Mgns55/chapter-ger/README.md

# Chapter Player for Audiobookshelf

> **Deutsche Fassung** von [chrismtopher/chapter](https://github.com/chrismtopher/chapter) mit deutscher Oberfläche, abschaltbarem Bluetooth und Leistungsverbesserungen für den Raspberry Pi Zero. Installation:
>
> ```bash
> curl -fsSL https://raw.githubusercontent.com/Mgns55/chapter-ger/v0.3.31/scripts/install-raspberry-pi.sh | bash
> ```
>
> **Zusätzlich in dieser Fassung**
>
> - **Serien** erscheinen im Menü als ein Eintrag; erst nach Auswahl kommen die einzelnen Folgen (in Reihenfolge). Abschaltbar unter *Einstellungen → Serien zusammenfassen*.
> - **Offline-Speicher**: gehörte Bücher liegen danach auf der SD-Karte, starten sofort und laufen auch ohne WLAN.
> - **Profile** (z. B. ein Audiobookshelf-Benutzer pro Kind): unter *Einrichtung* mit Profilname anmelden; am Player Menü-Knopf 3 Sekunden halten zum Wechseln (wenn Bluetooth aus ist).
> - **Akku** (PiSugar 3 / 3 Plus, wird automatisch erkannt): Ladestand im Display, Ansage bei 15 %, sauberes Herunterfahren bei 5 %.
> - **3,12″-Display** (SSD1322, z. B. UN312-5664-7): unter *Einstellungen → Display* wählen; lange Titel stehen dort zweizeilig. Steht das Bild auf dem Kopf: „3,12 Zoll gedreht“.
> - **Kein Knacken**: Verstärker im Leerlauf abschalten – dazu den SD-Pin des MAX98357A mit GPIO 17 (Pin 11) verbinden und unter *Einstellungen* einschalten.
> - **Home Assistant** per MQTT (automatische Erkennung): Status, Titel, Kapitel, Akku, Hörzeit, Lautstärke, Abspielen/Pause, Profilwahl.
> - **Kopfhörer** (optional, Buchse an der Klinke des Pi): unter *Einstellungen → Kopfhörerbuchse* einschalten; Umschalten über das Schnellmenü (Menü-Knopf 3 Sekunden halten), die Setup-Seite oder Home Assistant. Eigene Höchstlautstärke für Kopfhörer.
> - **Einschlaf-Timer am Gerät**: im Abspiel-Bildschirm auf *Nacht* → 15 Min, 30 Min oder Kapitelende; die Restzeit steht dann auf dem Knopf.
> - **Sortierung nach Datum hinzugefügt** (neueste zuerst) und **abgeschlossene Hörbücher ausblenden** unter *Einstellungen*.
> - **Hörzeit-Übersicht** für Eltern auf der Übersichtsseite: heute, letzte 7 Tage, meistgehörte Bücher, Hören nach 20 Uhr.



A simple Raspberry Pi friendly Chapter player for Audiobookshelf.

Current release: **[v0.3.12](https://github.com/chrismtopher/chapter/releases/tag/v0.3.12)**

Chapter Player for Audiobookshelf is an independent third-party project and is not affiliated with or supported by the Audiobookshelf project.

Chapter is a native Linux appliance app built with Python and GStreamer. It signs in to Audiobookshelf with a dedicated user account, securely stores the server-issued tokens, shows a simple two-line OLED library and playback interface, resumes from Audiobookshelf progress, and syncs progress back while listening.

The target device is a small enclosure with a 2.08 inch SH1122 SPI OLED, two KY-040 rotary encoders, a MAX98357A I2S amp, and an internal speaker.

## Quick Install

Flash Raspberry Pi OS Lite onto a Raspberry Pi Zero 2 W/WH, enable SSH, and connect to the Pi. The recommended setup username is `chapter` and hostname is `chapter-player`.

Then run:

```bash
curl -fsSL https://raw.githubusercontent.com/chrismtopher/chapter/v0.3.12/scripts/install-raspberry-pi.sh | bash
sudo reboot
```

The installer handles the software setup:

- system packages
- project clone/update in `/home/chapter/audiobookshelf-player`
- SPI enablement
- MAX98357A I2S audio and ALSA config
- setup web page service
- OLED service and boot splash
- port 80 setup-page proxy
- captive portal DNS helper
- Bluetooth unblock helper
- BlueALSA Bluetooth audio backend

For the complete hardware, flashing, wiring, setup, and troubleshooting walkthrough, see the [Raspberry Pi Zero 2 W install guide](docs/raspberry-pi-zero-2w-install.md).

## Hardware

Recommended build:

- Raspberry Pi Zero 2 WH, or Raspberry Pi Zero 2 W with a soldered 40-pin header
- 16 GB or larger microSD card
- Regulated 5 V power supply rated for at least 2 A; see the install guide for the Adafruit 5993's 1.5 A power-path limitation
- 2.08 inch 256x64 SH1122 SPI OLED
- Two KY-040 rotary encoder modules
- MAX98357A I2S mono amplifier breakout
- 4 ohm speaker
- 1.5 A inline fuse on the USB-C 5 V positive lead
- 3 mm warm-white power indicator LED for the lower-right front-cover hole
- Cross-connect wires for component wiring

The wiring tables are in the [install guide](docs/raspberry-pi-zero-2w-install.md#wire-the-hardware).

Purchase links for the recommended parts are in [docs/hardware-links.md](docs/hardware-links.md).

Printable case files are in [hardware/case](hardware/case).

## Setup

After installation and reboot, open the setup page from a phone or computer on the same network:

```text
http://chapter-player.local
```

If the player is not connected to Wi-Fi, it starts an open setup hotspot:

```text
Network:  Chapter-Setup
Password: none
Page:     http://10.42.0.1
```

The setup page lets you enter your Wi-Fi details and log the player into Audiobookshelf. Create a dedicated Audiobookshelf user for the player and restrict that user to the appropriate library or tags.

For a simple handout, see the [first boot one-sheet](docs/first-boot-one-sheet.md).

For a package-style quick start card, open the [PDF](docs/first-boot-quick-start.pdf) or [JPG](docs/first-boot-quick-start.jpg).

## Controls

- Turn the Select knob to browse books.
- Click the Select knob to choose.
- Turn the Volume knob to change volume.
- Click the Volume knob to mute or unmute.
- Hold the Volume knob for 10 seconds to show the setup address.
- Hold the Select knob for 3 seconds to open the Bluetooth menu.
- In the Bluetooth menu, turn the Select knob to choose `Enable`, `Disable`, `Pair`, `Unpair`, or `Back`, then click to select.
- To pair a speaker or headphones, put the device in pairing mode, choose `Pair`, wait for the device list, turn to the device name, and click to connect.
- Parents can enable `Spoken navigation` on the Settings tab to have the player read highlighted book titles and controls aloud. It is disabled by default.
- With spoken navigation enabled, Volume-knob changes are announced at 10% intervals, volume stops at 10%, and pressing the Volume knob does not mute the player.

## Features

- Two-line SH1122 OLED library and playback UI
- Select and Volume rotary controls
- Internal speaker playback through GStreamer
- Audiobookshelf login through the local setup page
- Admin web page player controls, including play/pause and volume
- Configurable `1x`, `1.5x`, and `2x` playback speed
- Configurable library ordering by title or author last name
- Optional offline spoken navigation for book titles and controls using a tuned eSpeak NG voice
- System-tab software update checks and one-button stable release installation
- Resume from Audiobookshelf progress
- Periodic progress sync back to Audiobookshelf
- Multi-file audiobook playback
- Continue/start-over prompt when a book has listening history
- Wi-Fi setup fallback hotspot

## Security

The administration page is intentionally passwordless and is intended only for a trusted private home network. Anyone who can reach it can control or reset the player. Do not expose the player to the internet, configure router port forwarding, or connect it to an untrusted network.

CSRF protection prevents unrelated websites from submitting commands through your browser, but it does not authenticate people already connected to the same network. Use a dedicated, restricted Audiobookshelf account for the player. See the full [security policy](SECURITY.md) for details and vulnerability-reporting instructions.

## Development

Run the test suite with:

```bash
python3 -m unittest discover -s tests
```

Run the isolated Raspberry Pi OS Lite installer simulation with:

```bash
tests/mock_raspberry_pi_install.sh
```

See [docs/appliance-design.md](docs/appliance-design.md) for hardware notes, UI behavior, and future direction.

Release history is recorded in [CHANGELOG.md](CHANGELOG.md).

## License

This project is open source under the terms of the [MIT License](LICENSE).
