Mgns55/chapter-ger/hardware/case/pro/stl/chapter-pro-lautsprecher-adapter.stl

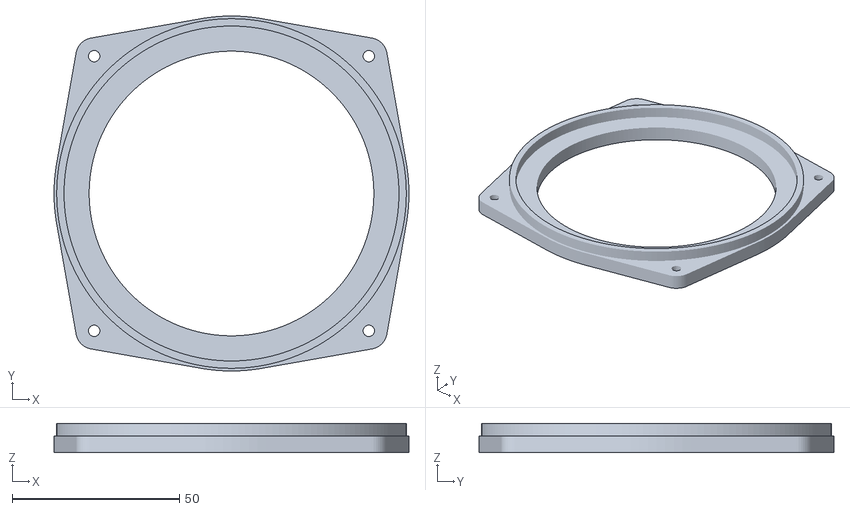
[picture p4: CAD file, 2026-11-08]
hardware/case/pro/stl/chapter-pro-lautsprecher-adapter.stl
106.0 x 106.0 x 8.79
