Mgns55/chapter-ger/hardware/case/stl/chapter-case-back-v5-zero-de.stl

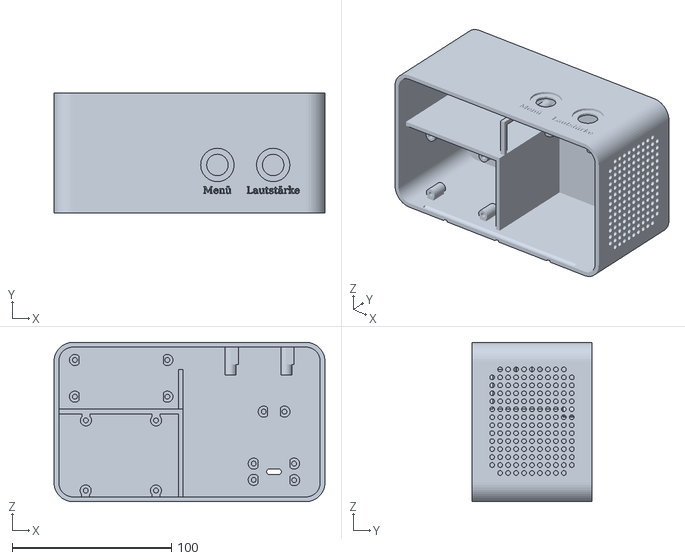
[picture p5: CAD file, 2026-10-25]
hardware/case/stl/chapter-case-back-v5-zero-de.stl
170.0 x 75.0 x 100.0
