Mgns55/chapter-ger/hardware/case/pro/stl/chapter-pro-rueckwand.stl

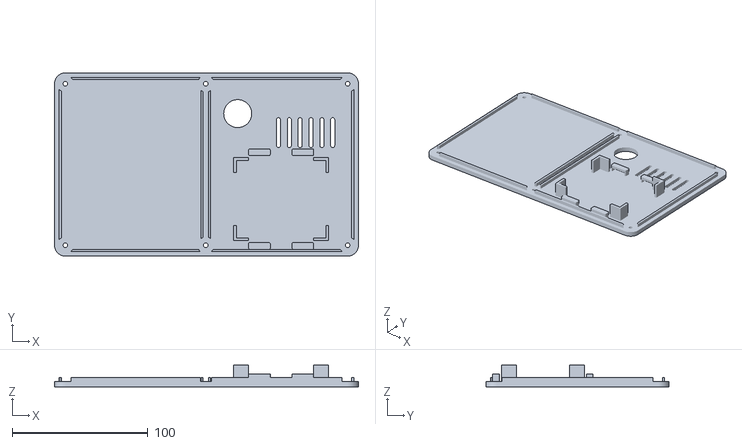
[picture p6: CAD file, 2026-11-01]
hardware/case/pro/stl/chapter-pro-rueckwand.stl
224.0 x 135.0 x 16.0
