Mgns55/chapter-ger/hardware/case/pro/stl/usb-loch-probe.stl

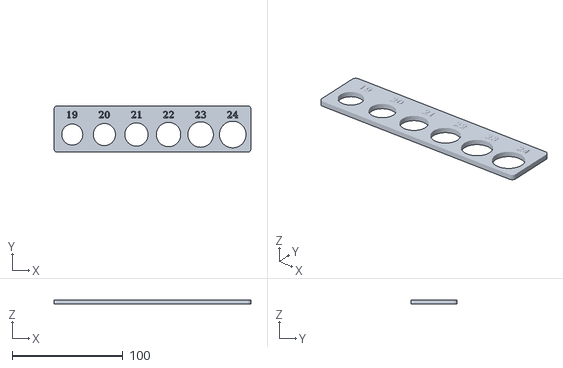
[picture p7: CAD file, 2026-11-01]
hardware/case/pro/stl/usb-loch-probe.stl
178.0 x 42.0 x 4.00
