Mgns55/chapter-ger/hardware/case/pro/stl/chapter-pro-gehaeuse.stl

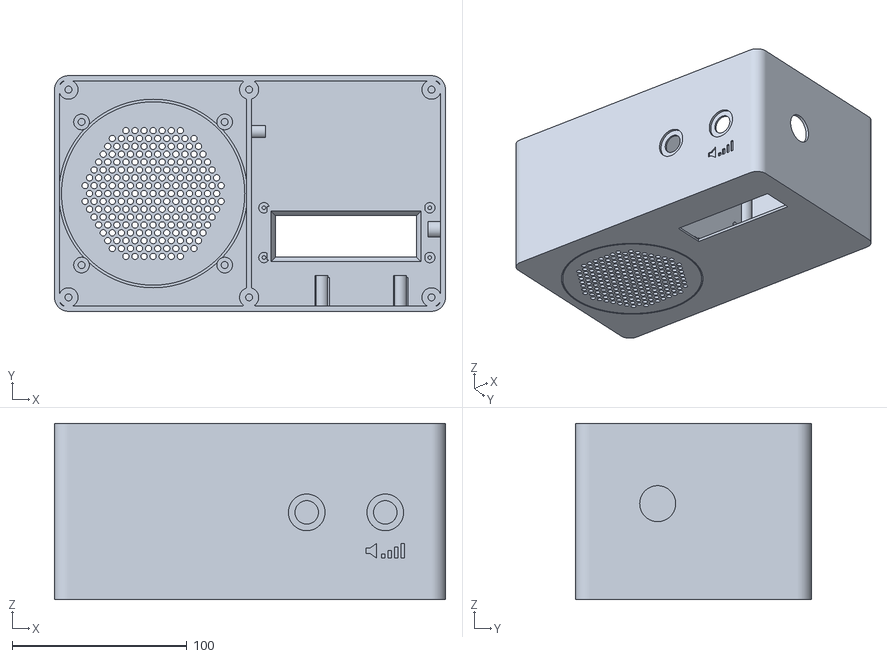
[picture p8: CAD file, 2026-10-29]
hardware/case/pro/stl/chapter-pro-gehaeuse.stl
224.0 x 135.0 x 101.0
