Mgns55/chapter-ger/hardware/case/pro/stl/chapter-pro-kopfhoererhalter.stl

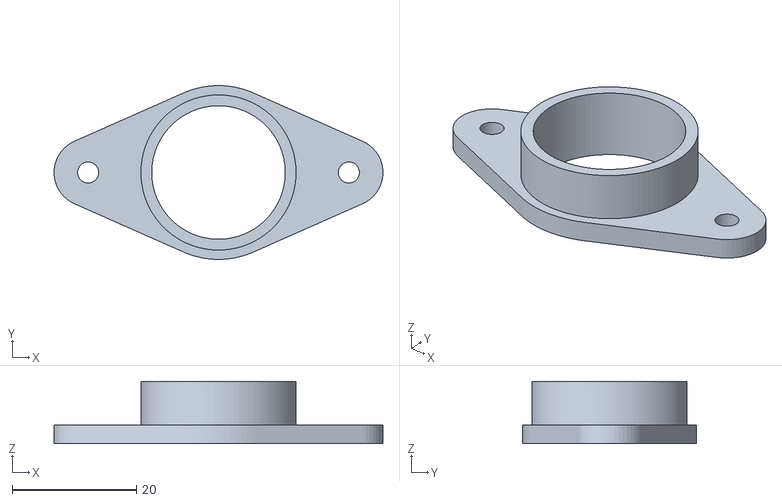
[picture p9: CAD file, 2026-10-27]
hardware/case/pro/stl/chapter-pro-kopfhoererhalter.stl
53.0 x 28.0 x 10.0
