Mgns55/chapter-ger/hardware/case/pro/stl/chapter-pro-lautsprecherring.stl

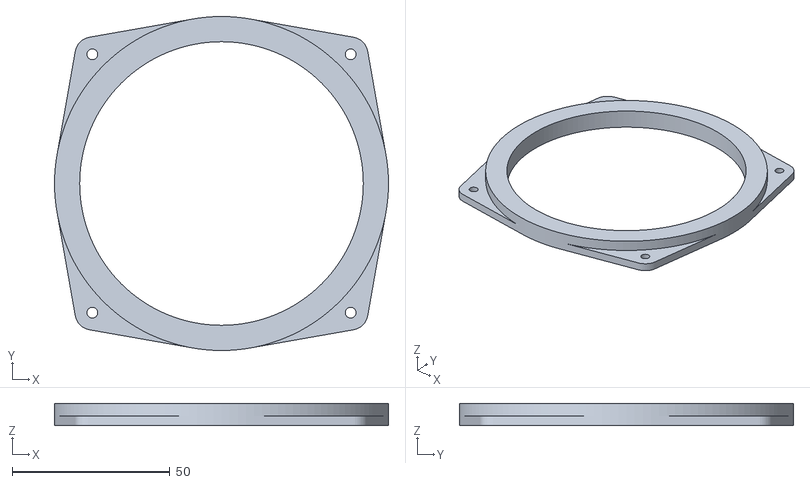
[picture p10: CAD file, 2026-10-25]
hardware/case/pro/stl/chapter-pro-lautsprecherring.stl
106.0 x 106.0 x 7.00
