Mgns55/chapter-ger/(list of files, cad)

Other CAD files:
hardware/case/stl/chapter-case-back-v5-pi3a.stl
