Mgns55/chapter-ger/docs/raspberry-pi-zero-2w-install.md

# Raspberry Pi Zero 2 W Install Guide

This guide walks through building a fresh Chapter Player for Audiobookshelf on a Raspberry Pi Zero 2 W or Zero 2 WH.

It assumes you already have an Audiobookshelf server running somewhere on your network or reachable by URL. The player stores an Audiobookshelf user token, so create a dedicated Audiobookshelf user for the player instead of using an admin account.

The software setup is handled by the installer. This guide covers the parts a new builder still needs: buying parts, flashing Raspberry Pi OS Lite, wiring the hardware, running the installer, opening the setup page, and troubleshooting.

## What To Buy

- Raspberry Pi Zero 2 WH, or a Raspberry Pi Zero 2 W plus a soldered 40-pin header.
- 16 GB or larger microSD card. Raspberry Pi OS Lite fits on less, but 16 GB or 32 GB gives you room for updates and logs.
- Good regulated 5 V power supply. Raspberry Pi recommends 2 A capacity for the Zero 2 W; 2.5 A provides additional source-side headroom for the OLED and speaker amp. See the USB-C power note below because the specified Adafruit 5993 breakout is the limiting component.
- 2.08 inch 256x64 SH1122 SPI OLED module.
- Two KY-040 rotary encoder modules.
- MAX98357A I2S mono amplifier breakout.
- 4 ohm speaker.
- 1.5 A inline fuse for the USB-C 5 V positive lead. The linked holder kit includes a suitable 1.5 A fast-blow 5x20 mm fuse.
- 3 mm warm-white power indicator LED for the lower-right front-cover hole. The build uses the 5-6 V [Dioramo 13240](https://dioramo.com/products/13240).
- Cross-connect wires or soldered wiring, plus an enclosure. The build uses [Amazon ASIN B01EV70C78](https://www.amazon.com/dp/B01EV70C78?th=1) for component wiring.

For links to the recommended parts, see the [hardware links](hardware-links.md).

The Pi Zero 2 W Wi-Fi radio is 2.4 GHz only. Use a 2.4 GHz network during setup.

## Flash Raspberry Pi OS

1. Install Raspberry Pi Imager on your computer.
2. Insert the microSD card.
3. In Imager, choose the Pi model and select **Raspberry Pi OS Lite**.
4. Open OS customisation before writing the card.
5. Set the hostname to `chapter-player`.
6. Set the username to `chapter`.
7. Set a password you will remember.
8. Configure your 2.4 GHz Wi-Fi network and country.
9. Enable SSH.
10. Write the card, insert it into the Pi, and power the Pi.

Wait a few minutes for the first boot. Then connect from your computer:

```bash
ssh chapter@chapter-player.local
```

If `.local` does not resolve on your network, find the Pi's IP address from your router and use:

```bash
ssh chapter@192.168.1.42
```

## Run The Installer

Run this on the Pi:

```bash
curl -fsSL https://raw.githubusercontent.com/chrismtopher/chapter/v0.3.12/scripts/install-raspberry-pi.sh | bash
```

The installer handles the software setup:

- installs required system packages
- creates or updates the `chapter` service user
- clones or updates the project in `/home/chapter/audiobookshelf-player`
- enables SPI for the OLED
- configures the MAX98357A I2S audio overlay
- installs the ALSA mixer config
- installs and enables the setup page service
- installs and enables the OLED service and boot splash
- installs the port 80 setup-page proxy
- installs the captive portal DNS helper
- installs the Bluetooth unblock helper
- installs and enables the BlueALSA Bluetooth audio backend

When it finishes, it will tell you to reboot. If you have not wired the hardware yet, shut the Pi down instead:

```bash
sudo shutdown -h now
```

If the hardware is already wired, reboot:

```bash
sudo reboot
```

To inspect the installer before running it:

```bash
curl -fsSLO https://raw.githubusercontent.com/chrismtopher/chapter/v0.3.12/scripts/install-raspberry-pi.sh
less install-raspberry-pi.sh
bash install-raspberry-pi.sh
```

## Wire The Hardware

Power the Pi off before wiring. Disconnect power, then wire the parts.

All `GPIO` numbers below use Raspberry Pi BCM numbering. The separate `Physical Pin` column identifies the numbered position on the 40-pin header. Do not confuse the two numbering systems.

### OLED

| OLED Pin | Raspberry Pi Signal | Physical Pin |
| --- | --- | ---: |
| `VCC` | 3.3 V | 1 |
| `GND` | GND | 6 |
| `SCL` / `CLK` | GPIO11 / SCLK | 23 |
| `SDA` / `DIN` | GPIO10 / MOSI | 19 |
| `CS` | GPIO8 / CE0 | 24 |
| `DC` | GPIO24 | 18 |
| `RES` / `RST` | GPIO25 | 22 |

### Select Knob (KY-040)

Power the KY-040 from 3.3 V, not 5 V.

| KY-040 Pin | Raspberry Pi Signal | Physical Pin |
| --- | --- | ---: |
| `+` | 3.3 V | 1 |
| `GND` | GND | 9 |
| `CLK` | GPIO5 | 29 |
| `DT` | GPIO6 | 31 |
| `SW` | GPIO13 | 33 |

### Volume Knob (KY-040)

| KY-040 Pin | Raspberry Pi Signal | Physical Pin |
| --- | --- | ---: |
| `+` | 3.3 V | 17 |
| `GND` | GND | 14 |
| `CLK` | GPIO12 | 32 |
| `DT` | GPIO16 | 36 |
| `SW` | GPIO26 | 37 |

### MAX98357A I2S Amp

| Amp Pin | Raspberry Pi Signal | Physical Pin |
| --- | --- | ---: |
| `VIN` | 5 V | 2 or 4 |
| `GND` | GND | 20, 25, 30, 34, or 39 |
| `BCLK` | GPIO18 | 12 |
| `LRC` / `LRCLK` | GPIO19 | 35 |
| `DIN` | GPIO21 | 40 |
| `SD` / `SD_MODE` | Leave disconnected | - |
| Speaker `+` / `-` | Speaker terminals | - |

The default software leaves `SD` / `SD_MODE` alone. That lets the breakout's own mode resistor choose the default mono mix.

The MAX98357A speaker output is differential. Connect the speaker only between the amplifier's `+` and `-` speaker terminals; do not connect either speaker terminal to Raspberry Pi ground. Keep the speaker pair short and, if practical, twisted together and routed away from the OLED and encoder wiring.

### USB-C Power Port And Fuse

If you are using the Adafruit 5993 vertical USB-C breakout as the rear power port, put a 1.5 A inline fuse on the positive 5 V leg coming from the USB-C board before it reaches the Raspberry Pi.

On the Adafruit 5993, solder the positive power lead to either pad labeled `VBUS` and the negative power lead to either pad labeled `GND`. The two breakout rows are duplicates, so either matching `VBUS`/`GND` pair may be used. `VBUS` is the raw 5 V supply from the USB-C connector; do not substitute a `CC`, `SBU`, `D+`, or `D-` pad for either power connection. Using red wire for `VBUS` and black wire for `GND` is recommended.

The build uses the holder and fuse assortment in [Amazon ASIN B0813Q4S6P](https://www.amazon.com/dp/B0813Q4S6P). Install the included **1.5 A fast-blow 5x20 mm fuse** in the holder; do not select one of the higher-current fuses from the assortment.

```text
Adafruit 5993 VBUS pad (+5 V) -> 1.5 A fuse -> Raspberry Pi 5 V pin 2 or 4
Adafruit 5993 GND pad  (-)    -> Raspberry Pi GND
```

Any 5 V branch for the amp should be taken from the fused 5 V side. Do not put the fuse in series with `GND`, `D+`, or `D-`.

Leave `D+`, `D-`, `CC`, and `SBU` unwired in the Chapter build. The Adafruit 5993 is used for 5 V power only.

Adafruit documents this breakout's USB-C current arrangement for 5 V at up to 1.5 A, while Raspberry Pi recommends a 2 A-capable supply for a Zero 2 W by itself. The tested Chapter build normally remains within the breakout's limit, but the 5993 is the power-path constraint. If the Pi reports undervoltage, reboots at high volume, or behaves unreliably, stop using it until you replace the input path with a regulated 5 V solution rated for at least 2 A.

Feeding the Pi through a 5 V header pin bypasses the Pi's normal power-input protection. Verify polarity and voltage before connecting it. Never power Chapter through the Adafruit breakout and the Pi's original `PWR IN` micro-USB port at the same time.

### Power Indicator LED

The small hole at the lower-right of the front cover, viewed from the outside, is for the power indicator. Insert the 3 mm LED into the hole from the back of the cover, then secure it with a small dab of hot glue. Keep glue away from the LED leads and wire joints.

Splice the LED into the USB-C power wiring as a parallel branch after the fuse. It must not be placed in series with either power lead; the Pi must still have a direct fused 5 V and ground connection.

The [Dioramo 13240](https://dioramo.com/products/13240) is rated for 5-6 V and has its current-limiting resistor already wired in. Its white-marked wire is the positive anode and its black wire is the negative cathode, so no additional resistor is required on Chapter's 5 V rail.

```text
Fused USB-C 5 V ----+------------------------> Raspberry Pi 5 V / amp 5 V
                    |
                    +-----------------------> Dioramo 13240 white-marked wire (+)

USB-C GND ----------+------------------------> Raspberry Pi GND / amp GND
                    |
                    +-----------------------> Dioramo 13240 black wire (-)
```

The LED illuminates as soon as USB power is present, providing immediate feedback while the Pi boots and before the OLED service starts.

## First Boot

After the installer has run and the hardware is wired, power the Pi on.

On boot, the OLED should show `chapter` and then one of these:

- setup page address
- setup hotspot instructions
- library home screen

The installer starts the setup page and OLED services automatically on boot.

## Open The Setup Page

If the Pi is on your Wi-Fi, open one of these from a phone or computer on the same network:

```text
http://chapter-player.local
http://<the-pi-ip-address>
```

The setup page also runs directly on port `47831`:

```text
http://chapter-player.local:47831
```

The setup page intentionally has no password and must remain on a trusted private home network. Do not expose ports `80` or `47831` to the internet or configure router port forwarding for the player. See the [security policy](../SECURITY.md) for the complete network-safety guidance.

If the Pi is not connected to Wi-Fi, the setup service should start an open setup hotspot:

```text
Network:  Chapter-Setup
Password: none
Page:     http://10.42.0.1
```

Connect a phone or laptop to `Chapter-Setup`, then open `http://10.42.0.1`.

## Connect Audiobookshelf

On the setup page, enter:

- Audiobookshelf server URL, for example `https://books.example.com`.
- Username for the dedicated player user.
- Password for that user.

The password is sent to Audiobookshelf once. The player stores the returned user token, not the password.

If no library is selected, the player uses the user's default audiobook library or the first accessible audiobook library.

## Using The Player

- Turn the Select knob to browse books.
- Click the Select knob to choose.
- Turn the Volume knob to change volume.
- Click the Volume knob to mute or unmute.
- Hold the Volume knob for 10 seconds to show the setup address.
- When spoken navigation is enabled, Volume-knob changes are announced at 10% intervals, volume stops at 10%, and pressing the Volume knob does not mute the player.

## Updating Later

Run the installer again:

```bash
curl -fsSL https://raw.githubusercontent.com/chrismtopher/chapter/v0.3.12/scripts/install-raspberry-pi.sh | bash
sudo reboot
```

This reinstalls the tested `v0.3.12` release and refreshes the installed service files. To move to a later release, use the versioned command published for that release. For development builds, the installer also accepts `--release-ref REF` or the `CHAPTER_RELEASE_REF` environment variable.

After installing a release that includes device updates, open the **System** tab on the Chapter administration page. The player checks the public Chapter release tags and offers an **Update** button only when a newer stable version is available. Updating pauses playback, keeps the device configuration and listening state, installs the newest stable release, and restarts the player services. Keep the player powered on and connected to the internet until the administration page becomes available again.

## Troubleshooting

### SSH Does Not Connect

Make sure the Pi was flashed with SSH enabled, the hostname is `chapter-player`, and the Wi-Fi network is 2.4 GHz. If `.local` does not work, use the IP address from your router.

### OLED Is Blank

Check that SPI exists and that the `chapter` user has device permissions:

```bash
ls /dev/spidev*
groups chapter
```

Run the OLED test from the installed project:

```bash
cd /home/chapter/audiobookshelf-player
python3 -m abs_kids_player.oled_test
```

If `/dev/spidev0.0` is missing, rerun the installer and reboot. If the OLED test still stays blank, power off and re-check `VCC`, `GND`, `CLK`, `DIN`, `CS`, `DC`, and `RES`.

### No Sound

Check that ALSA sees the amp:

```bash
aplay -l
speaker-test -t wav -c 2
```

Press `Ctrl+C` to stop the speaker test.

If there is no sound card, rerun the installer and reboot. If there is a sound card but no audio, re-check the speaker wires and MAX98357A `VIN` and `GND`.

### Setup Page Does Not Open

Check the setup service and health endpoint:

```bash
systemctl status audiobookshelf-player-setup.service
curl http://localhost:47831/health
```

If the direct port works but `http://chapter-player.local` does not, check the port 80 proxy:

```bash
systemctl status audiobookshelf-player-port80-forward.service
curl http://localhost/health
```

### The Pi Shows The Setup Hotspot Instead Of Joining Wi-Fi

Connect to `Chapter-Setup`, open `http://10.42.0.1`, and enter the home Wi-Fi credentials. The setup page uses NetworkManager to switch from the hotspot to the selected Wi-Fi network.

### View Service Logs

```bash
journalctl -u audiobookshelf-player-setup.service -n 80
journalctl -u audiobookshelf-player-oled.service -n 80
tail -n 80 /home/chapter/audiobookshelf-player-oled.log
```

## References

- Raspberry Pi getting started guide: https://www.raspberrypi.com/documentation/computers/getting-started.html
- Raspberry Pi Zero 2 W hardware information: https://www.raspberrypi.com/documentation/computers/raspberry-pi.html
- Raspberry Pi configuration guide: https://www.raspberrypi.com/documentation/computers/configuration.html
- Adafruit MAX98357A Raspberry Pi setup: https://learn.adafruit.com/adafruit-max98357-i2s-class-d-mono-amp/raspberry-pi-usage
