Mgns55/chapter-ger/abs_kids_player/wifi.py

from __future__ import annotations

import shutil
import subprocess
import time
from dataclasses import dataclass
from typing import Callable


SETUP_HOTSPOT_SSID = "Chapter-Setup"
SETUP_HOTSPOT_PASSWORD = ""
SETUP_HOTSPOT_URL = "http://10.42.0.1"


class WifiError(RuntimeError):
    pass


@dataclass(frozen=True)
class WifiDevice:
    name: str
    state: str


@dataclass(frozen=True)
class WifiStatus:
    connected: bool
    ssid: str = ""
    message: str = ""


CommandRunner = Callable[[list[str]], subprocess.CompletedProcess]


def run_command(args: list[str]) -> subprocess.CompletedProcess:
    return subprocess.run(args, capture_output=True, check=True, text=True)


def require_nmcli() -> None:
    if shutil.which("nmcli") is None:
        raise WifiError("NetworkManager nmcli command was not found.")


def nmcli(args: list[str], runner: CommandRunner = run_command) -> subprocess.CompletedProcess:
    if runner is run_command:
        require_nmcli()
    try:
        return runner(["nmcli", *args])
    except subprocess.CalledProcessError as error:
        details = (error.stderr or error.stdout or str(error)).strip()
        raise WifiError(details) from error


def wifi_devices(runner: CommandRunner = run_command) -> list[WifiDevice]:
    result = nmcli(["-t", "-f", "DEVICE,TYPE,STATE", "device", "status"], runner)
    devices: list[WifiDevice] = []
    for line in result.stdout.splitlines():
        parts = line.split(":")
        if len(parts) >= 3 and parts[1] == "wifi":
            devices.append(WifiDevice(name=parts[0], state=parts[2]))
    return devices


def choose_wifi_device(runner: CommandRunner = run_command) -> str:
    devices = wifi_devices(runner)
    if not devices:
        raise WifiError("No Wi-Fi device was found.")
    return devices[0].name


def wifi_is_connected(runner: CommandRunner = run_command) -> bool:
    return any(device.state == "connected" for device in wifi_devices(runner))


def current_wifi_ssid(runner: CommandRunner = run_command) -> str:
    # "--rescan no": answer from the cache instead of starting a Wi-Fi scan on every status check.
    result = nmcli(["-t", "-f", "ACTIVE,SSID", "device", "wifi", "list", "--rescan", "no"], runner)
    for line in result.stdout.splitlines():
        fields = split_nmcli_fields(line)
        if len(fields) >= 2 and fields[0] == "yes":
            return fields[1]
    return ""


def wifi_status(runner: CommandRunner = run_command) -> WifiStatus:
    try:
        ssid = current_wifi_ssid(runner)
        if ssid:
            return WifiStatus(connected=True, ssid=ssid)
        if wifi_is_connected(runner):
            return WifiStatus(connected=True, message="Connected, SSID unavailable")
        return WifiStatus(connected=False, message="Not connected")
    except WifiError as error:
        return WifiStatus(connected=False, message=str(error))


def active_wifi_connection_name(runner: CommandRunner = run_command) -> str:
    result = nmcli(["-t", "-f", "NAME,TYPE", "connection", "show", "--active"], runner)
    for line in result.stdout.splitlines():
        fields = split_nmcli_fields(line)
        if len(fields) >= 2 and fields[1] in {"802-11-wireless", "wifi"}:
            return fields[0]
    return ""


def saved_wifi_connection_names(runner: CommandRunner = run_command) -> list[str]:
    result = nmcli(["-t", "-f", "NAME,TYPE", "connection", "show"], runner)
    names: list[str] = []
    for line in result.stdout.splitlines():
        fields = split_nmcli_fields(line)
        if len(fields) >= 2 and fields[1] in {"802-11-wireless", "wifi"} and fields[0]:
            names.append(fields[0])
    return names


def connect_wifi(
    ssid: str,
    password: str,
    device: str | None = None,
    runner: CommandRunner = run_command,
    sleep: Callable[[float], None] = time.sleep,
) -> None:
    """Save the network as a permanent profile, then switch to it.

    `nmcli device wifi connect` only works for networks in the current scan
    list - and while the setup hotspot runs, the radio does not scan, so the
    home network was never found and nothing was saved. Instead the profile is
    created first (it survives reboots even if joining fails right now), the
    hotspot is stopped, and only then the connection is brought up. If that
    fails, the hotspot comes back so the setup page stays reachable.
    """
    ssid = ssid.strip()
    if not ssid:
        raise WifiError("Wi-Fi network name is required.")

    device = device or choose_wifi_device(runner)
    delete_connection(ssid, runner=runner, missing_ok=True)
    args = [
        "connection", "add", "type", "wifi", "ifname", device,
        "con-name", ssid, "ssid", ssid,
        "connection.autoconnect", "yes", "connection.autoconnect-priority", "10",
    ]
    if password:
        args.extend(["wifi-sec.key-mgmt", "wpa-psk", "wifi-sec.psk", password])
    nmcli(args, runner)

    deactivate_connection(SETUP_HOTSPOT_SSID, runner=runner, missing_ok=True)
    try:
        nmcli(["device", "wifi", "rescan", "ifname", device], runner)
    except WifiError:
        pass
    sleep(4.0)
    try:
        nmcli(["--wait", "40", "connection", "up", "id", ssid], runner)
    except WifiError as error:
        try:
            start_setup_hotspot(device=device, runner=runner)
        except WifiError:
            pass
        raise WifiError(f"Saved {ssid}, but could not join it now: {error}") from error


def hotspot_has_clients(device: str = "wlan0", runner: CommandRunner = run_command) -> bool:
    """True if a phone/laptop is connected to the setup hotspot (unknown counts as yes)."""
    try:
        result = runner(["iw", "dev", device, "station", "dump"])
    except (OSError, subprocess.CalledProcessError):
        return True
    return "Station" in (result.stdout or "")


def retry_home_wifi_from_hotspot(runner: CommandRunner = run_command) -> str:
    """While the setup hotspot runs without visitors, try the saved home network again.

    Covers a player that started away from home (e.g. in the car): back home it
    reconnects by itself instead of staying in setup mode until the next reboot.
    """
    if current_wifi_ssid(runner) != SETUP_HOTSPOT_SSID:
        return "not-in-hotspot"
    homes = [name for name in saved_wifi_connection_names(runner) if name != SETUP_HOTSPOT_SSID]
    if not homes:
        return "no-saved-network"
    device = choose_wifi_device(runner)
    if hotspot_has_clients(device, runner):
        return "hotspot-in-use"
    deactivate_connection(SETUP_HOTSPOT_SSID, runner=runner, missing_ok=True)
    for name in homes:
        try:
            nmcli(["--wait", "30", "connection", "up", "id", name], runner)
            return f"connected:{name}"
        except WifiError:
            continue
    start_setup_hotspot(device=device, runner=runner)
    return "hotspot-restarted"


def start_setup_hotspot(
    ssid: str = SETUP_HOTSPOT_SSID,
    password: str = SETUP_HOTSPOT_PASSWORD,
    device: str | None = None,
    runner: CommandRunner = run_command,
) -> None:
    if password and len(password) < 8:
        raise WifiError("Setup hotspot password must be at least 8 characters.")

    device = device or choose_wifi_device(runner)
    if not password:
        start_open_setup_hotspot(ssid, device, runner)
        return

    nmcli(
        [
            "device",
            "wifi",
            "hotspot",
            "ifname",
            device,
            "con-name",
            ssid,
            "ssid",
            ssid,
            "password",
            password,
        ],
        runner,
    )


def start_open_setup_hotspot(
    ssid: str = SETUP_HOTSPOT_SSID,
    device: str | None = None,
    runner: CommandRunner = run_command,
) -> None:
    device = device or choose_wifi_device(runner)
    delete_connection(ssid, runner=runner, missing_ok=True)
    nmcli(
        [
            "connection",
            "add",
            "type",
            "wifi",
            "ifname",
            device,
            "con-name",
            ssid,
            "autoconnect",
            "no",
            "ssid",
            ssid,
        ],
        runner,
    )
    nmcli(
        [
            "connection",
            "modify",
            ssid,
            "802-11-wireless.mode",
            "ap",
            "802-11-wireless.band",
            "bg",
            "ipv4.method",
            "shared",
            "ipv6.method",
            "disabled",
        ],
        runner,
    )
    nmcli(["connection", "up", ssid], runner)


def delete_connection(
    connection_name: str,
    runner: CommandRunner = run_command,
    missing_ok: bool = False,
) -> None:
    try:
        nmcli(["connection", "delete", "id", connection_name], runner)
    except WifiError:
        if not missing_ok:
            raise


def deactivate_connection(
    connection_name: str,
    runner: CommandRunner = run_command,
    missing_ok: bool = False,
) -> None:
    try:
        nmcli(["connection", "down", "id", connection_name], runner)
    except WifiError:
        if not missing_ok:
            raise


def disconnect_wifi_device(
    device: str,
    runner: CommandRunner = run_command,
    missing_ok: bool = False,
) -> None:
    try:
        nmcli(["device", "disconnect", device], runner)
    except WifiError:
        if not missing_ok:
            raise


def forget_current_wifi_and_start_hotspot(runner: CommandRunner = run_command) -> None:
    device = choose_wifi_device(runner)
    connection_name = active_wifi_connection_name(runner)
    if connection_name:
        deactivate_connection(connection_name, runner=runner, missing_ok=True)
        delete_connection(connection_name, runner=runner)

    disconnect_wifi_device(device, runner=runner, missing_ok=True)
    start_setup_hotspot(device=device, runner=runner)


def forget_all_wifi_connections_and_start_hotspot(runner: CommandRunner = run_command) -> None:
    device = choose_wifi_device(runner)
    for connection_name in saved_wifi_connection_names(runner):
        if connection_name == SETUP_HOTSPOT_SSID:
            continue
        deactivate_connection(connection_name, runner=runner, missing_ok=True)
        delete_connection(connection_name, runner=runner, missing_ok=True)

    disconnect_wifi_device(device, runner=runner, missing_ok=True)
    start_setup_hotspot(device=device, runner=runner)


def ensure_wifi_or_hotspot(
    runner: CommandRunner = run_command,
    wait_seconds: float = 0.0,
    poll_seconds: float = 3.0,
    sleep: Callable[[float], None] = time.sleep,
    clock: Callable[[], float] = time.monotonic,
) -> str:
    if wifi_is_connected(runner):
        return "wifi-connected"
    # A slow board can reach this point before NetworkManager has joined the
    # saved home network. Give a saved network time to connect instead of
    # taking the Wi-Fi radio over with the setup hotspot right away.
    if wait_seconds > 0 and has_saved_home_wifi(runner):
        deadline = clock() + wait_seconds
        while clock() < deadline:
            sleep(poll_seconds)
            if wifi_is_connected(runner):
                return "wifi-connected"
    start_setup_hotspot(runner=runner)
    return "hotspot-started"


def has_saved_home_wifi(runner: CommandRunner = run_command) -> bool:
    try:
        names = saved_wifi_connection_names(runner)
    except WifiError:
        return False
    return any(name != SETUP_HOTSPOT_SSID for name in names)


def split_nmcli_pair(line: str) -> tuple[str, str]:
    active, separator, value = line.partition(":")
    if not separator:
        return active, ""
    return unescape_nmcli(active), unescape_nmcli(value)


def split_nmcli_fields(line: str) -> list[str]:
    fields: list[str] = []
    current: list[str] = []
    escaped = False
    for character in line:
        if escaped:
            current.append(character)
            escaped = False
            continue
        if character == "\\":
            escaped = True
            continue
        if character == ":":
            fields.append("".join(current))
            current = []
            continue
        current.append(character)
    if escaped:
        current.append("\\")
    fields.append("".join(current))
    return fields


def unescape_nmcli(value: str) -> str:
    return value.replace("\\:", ":").replace("\\\\", "\\")
