Mgns55/chapter-ger/(commit log)

2026-10-25 Deutsche Oberfläche für Display, Sprachausgabe und Setup-Seite
    Übersetzt an den Ausgabestellen (OLED, espeak-ng, HTML/JSON); die
    Programmlogik vergleicht weiter englische Werte. Sprache über
    CHAPTER_LANGUAGE (de/en), Standard Englisch.
    Claude-Session: https://claude.ai/code/session_01MRJeBfH7cTjqDF2ZihC3RN
2026-10-25 Installer und Updates auf Mgns55/chapter-ger umstellen
    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
2026-10-25 v0.3.13: Bluetooth abschaltbar, flüssigeres Display, weniger Hintergrundlast
    - Einstellung "Bluetooth" auf der Setup-Seite: Funk per rfkill aus,
    kein Bluetooth-Menü am Select-Knopf, Seite ohne bluetoothctl-Abfragen
    - Display: gleiche Bilder werden übersprungen, schnelle Bildumwandlung,
    SPI 4 MHz statt 1 MHz, Übertragung mit writebytes2
    - WLAN-Status mit --rescan no und alle 5 statt 2 Sekunden
    - Wiedergabestatus nur bei Änderung bzw. alle 2 Sekunden schreiben
    - Klickgeräusch-Einstellung aus dem geladenen Config statt pro Klick lesen
    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
2026-10-25 v0.3.16: Setup-Seite schneller und ohne 502 auf langsamen Boards
    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
2026-10-25 Gehäuse-Rückteil für Raspberry Pi 3 Model A+
    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
    [chapter-case-back-v5-pi3a.stl]
2026-10-25 Gehäuse: deutsche Gravur Menü/Lautstärke, auch als Pi-Zero-Variante
    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
    [chapter-case-back-v5-pi3a.stl, chapter-case-back-v5-zero-de.stl]
2026-10-25 Chapter Pro: parametrisches Gehäuse Variante A (Radio) für ND90-4, 3,12" OLED, Pi 3 A+ mit PiSugar 3 Plus
    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
    [chapter-pro-displayklemmen.stl, chapter-pro-gehaeuse.stl, chapter-pro-lautsprecherring.stl, chapter-pro-rueckwand.stl]
2026-10-25 Chapter Pro: Display nach Datenblatt UN312-5664-7, Halter für Pi/PiSugar, Gravur Franz Pro
    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
    [chapter-pro-displayklemmen.stl, chapter-pro-gehaeuse.stl, chapter-pro-rueckwand.stl]
2026-10-26 Chapter Pro: Rückwand für USB-C-Einbaubuchse mit 17 mm Lochabstand
    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
    [chapter-pro-rueckwand.stl]
2026-10-27 Chapter Pro: Kopfhörerbuchse oben, Gravur Franz Pro auf die Unterseite
    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
    [chapter-pro-gehaeuse.stl]
2026-10-27 v0.3.20: Kopfhörerausgabe mit Schnellmenü und Lautstärkegrenze; Gehäuse mit Kopfhörerbuchse an der Seite
    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
    [chapter-pro-gehaeuse.stl]
2026-10-27 Chapter Pro: Schraublöcher der Kopfhörerbuchse nach Maßzeichnung (25 mm)
    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
    [chapter-pro-gehaeuse.stl]
2026-10-27 Chapter Pro: Kopfhörerbuchse von innen montiert (rundes Loch, Halter, keine sichtbaren Schrauben)
    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
    [chapter-pro-gehaeuse.stl, chapter-pro-kopfhoererhalter.stl]
2026-10-27 Chapter Pro: Drehgeber-Halterung wie im Original-Chapter (Dome mit M2,5-Einsätzen, Knopfmulde)
    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
    [chapter-pro-gehaeuse.stl]
2026-10-27 Chapter Pro: Dome für den MAX98357A an der Trennwand
    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
    [chapter-pro-gehaeuse.stl]
2026-10-27 Chapter Pro: Loch für 12-mm-Einschaltknopf oben
    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
    [chapter-pro-gehaeuse.stl]
2026-10-27 v0.3.22: Bücherliste robuster und schneller aktualisieren
    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
2026-10-28 v0.3.23: Downloads schonender (Tempo-Limit, niedrige Priorität, regelmäßig auf SD schreiben), Gesundheits-Log und Diagnose-Skript, Bildschirmschoner zeigt Gerätenamen
    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
2026-10-28 v0.3.24: Player-Log rotieren, Diagnose liest das richtige Log und erkennt Desktop
    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
2026-10-29 v0.3.28: Einschlaf-Timer am Gerät, Sortierung nach Datum, abgeschlossene Bücher ausblenden, Franz-Branding
    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
2026-10-29 Chapter Pro: Stützwand unter den Drehgeber-Halterungen (druckbar ohne Supports, steifer)
    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
    [chapter-pro-gehaeuse.stl]
2026-10-29 Chapter Pro v7: ohne Einschaltknopf-Loch und Beschriftung, Lautstärke-Symbol vor dem rechten Knopf
    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
    [chapter-pro-gehaeuse.stl]
2026-10-29 Chapter Pro v8: Verstärker-Dome und Kabeldurchführung nach vorn (weniger Stützmaterial)
    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
    [chapter-pro-gehaeuse.stl]
2026-10-29 v0.3.31: WLAN-Stromsparen aus, Diagnose prüft Erreichbarkeit von Einrichtungsseite und Audiobookshelf
    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
2026-10-29 Chapter Pro: Rückwand mit rundem Loch für USB-C-Einbaubuchse mit Gewinde (Ø 23,5 mm)
    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
    [chapter-pro-rueckwand.stl]
2026-10-30 Chapter Pro: USB-C-Loch auf gemessenes Gewinde 18 mm angepasst (Ø 18,5 mm)
    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
    [chapter-pro-rueckwand.stl]
2026-11-01 Chapter Pro: Probestück für das USB-C-Loch (19–24 mm)
    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
    [usb-loch-probe.stl]
2026-11-01 Chapter Pro: USB-C-Loch Ø 20,6 mm (Gewinde gemessen 20 mm)
    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
    [chapter-pro-rueckwand.stl]
2026-11-08 Chapter Pro: Lautsprecher-Adapter für den eckigen ND90-4-Korb (passt aufs gedruckte Gehäuse)
    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
    [chapter-pro-lautsprecher-adapter.stl]
